Ahnaf-nub/mechaScratch404/chassis/Chassis_Base_2.jpg

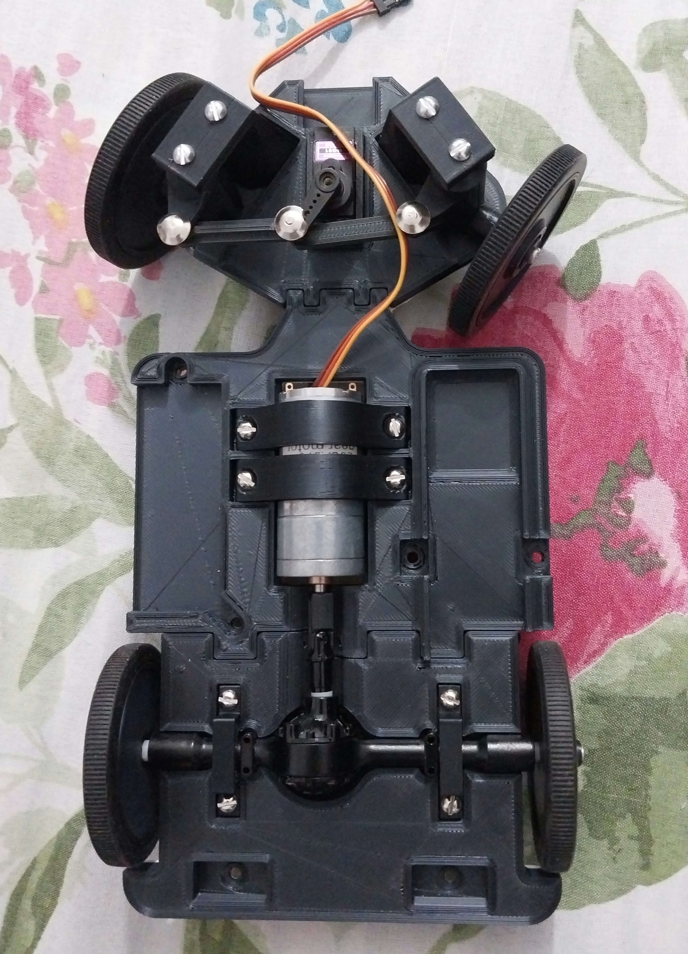
chassis/Chassis_Base_2.jpg
