Ahnaf-nub/mechaScratch404/chassis/Chassis_Base_1.jpg

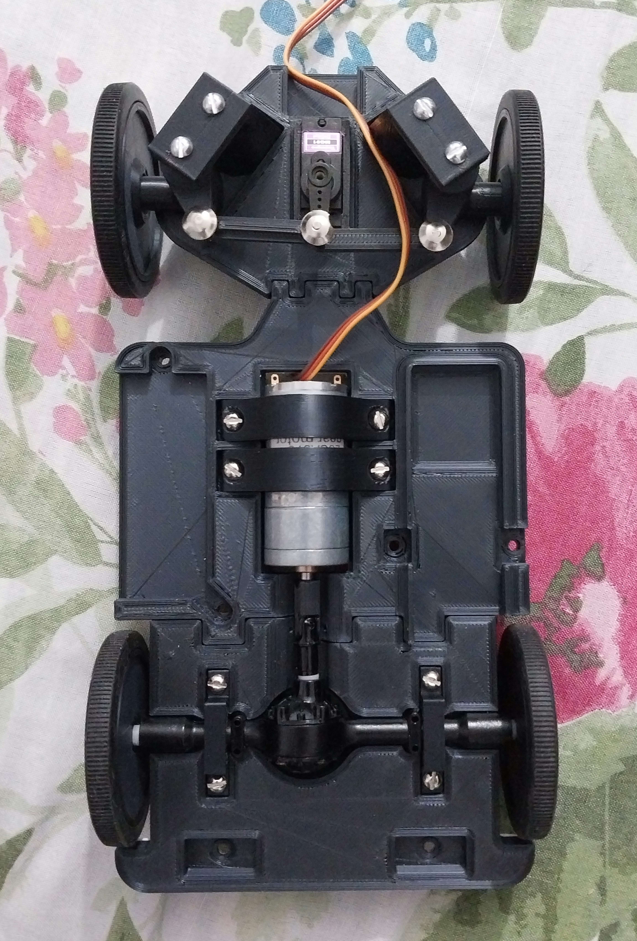
chassis/Chassis_Base_1.jpg
