Ahnaf-nub/mechaScratch404/chassis/README.md

# Overview
This folder contains pictures of the chassis that we used on our robot. This chassis has been designed for 3D printing and is divided into sections, allowing for printing on a relatively smaller print bed.
