Ahnaf-nub/mechaScratch404/schematic/README.md

# Circuit schematics
This folder contains the schematic of the circuit used in the robot.
