Ahnaf-nub/mechaScratch404/schematic/ESP32_Pins_Connections.png

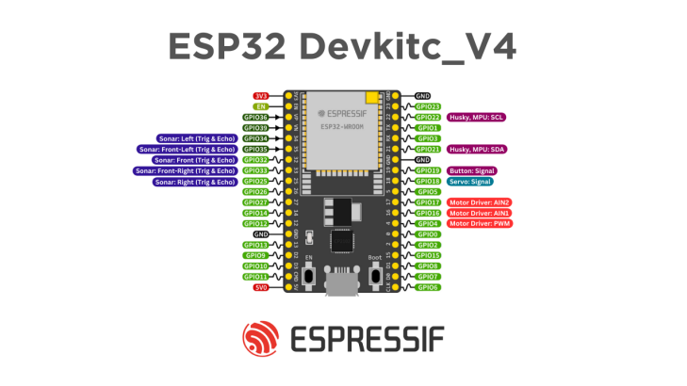
schematic/ESP32_Pins_Connections.png
