Ahnaf-nub/mechaScratch404/schematic/Schematic_esp32_fe_2023-09-10.png

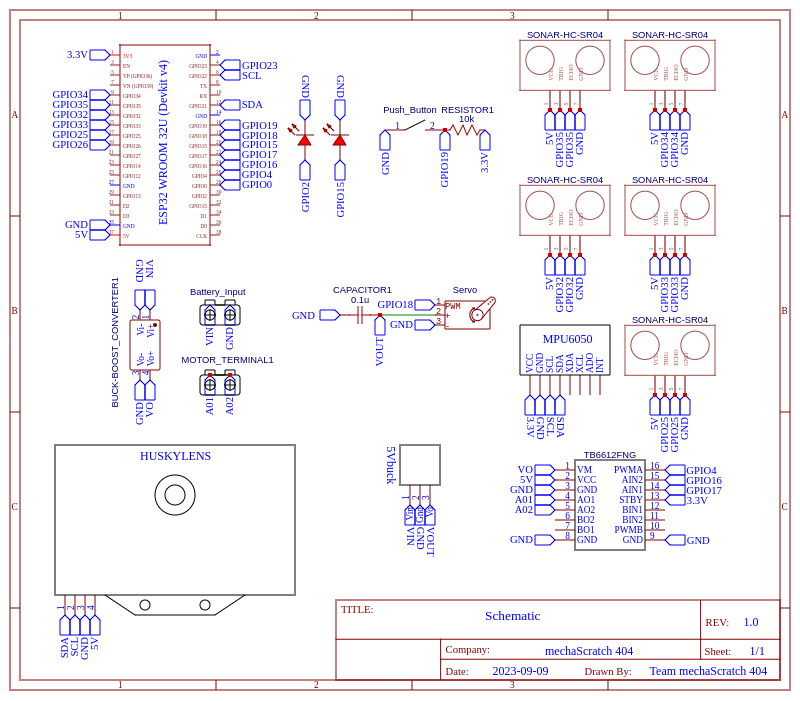
schematic/Schematic_esp32_fe_2023-09-10.png
