Ahnaf-nub/mechaScratch404/v-photos/Back.jpg

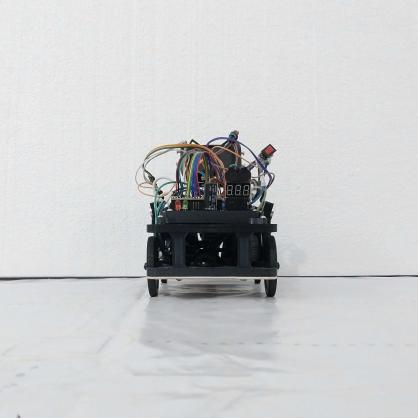
v-photos/Back.jpg
