Ahnaf-nub/mechaScratch404/v-photos/Bottom.jpg

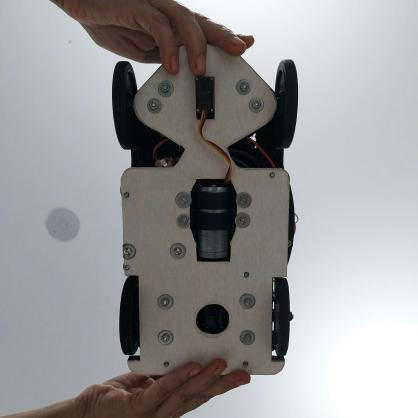
v-photos/Bottom.jpg
