Ahnaf-nub/mechaScratch404/v-photos/Front.jpg

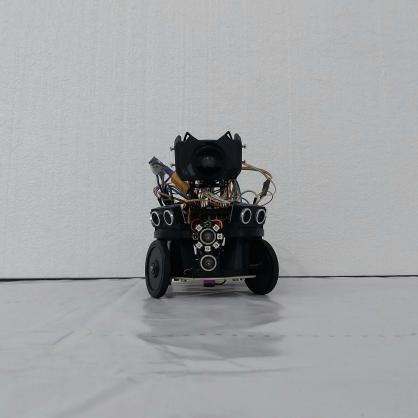
v-photos/Front.jpg
