Ahnaf-nub/mechaScratch404/v-photos/Left.jpg

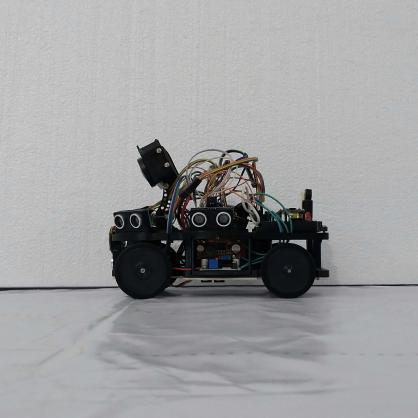
v-photos/Left.jpg
