Ahnaf-nub/mechaScratch404/v-photos/Right.jpg

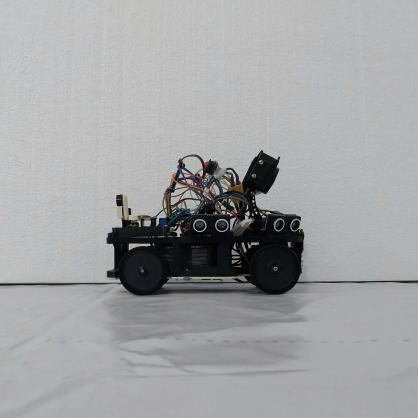
v-photos/Right.jpg
