Ahnaf-nub/mechaScratch404/v-photos/Top.jpg

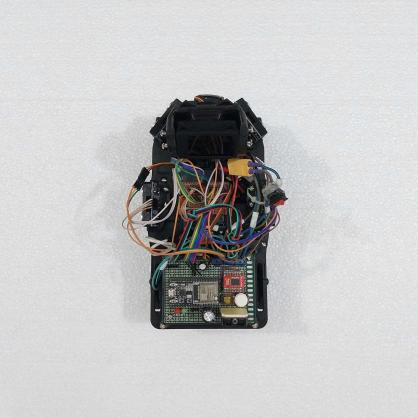
v-photos/Top.jpg
