Ahnaf-nub/mechaScratch404/models/Model_SteerLink (2x).stl

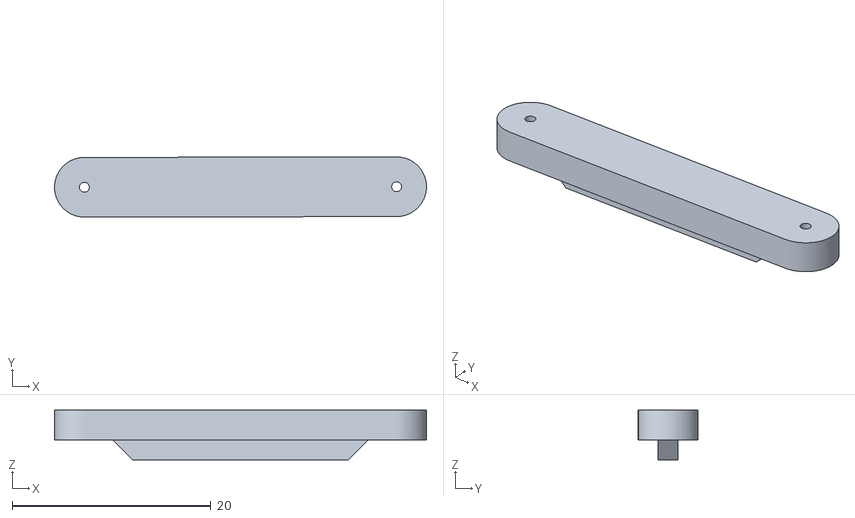
[picture p11: CAD file, 2023-09-09]
models/Model_SteerLink (2x).stl
37.4 x 6.05 x 5.00
