Ahnaf-nub/mechaScratch404/models/Model_Top_Sonar_Mount_Ang_L.stl

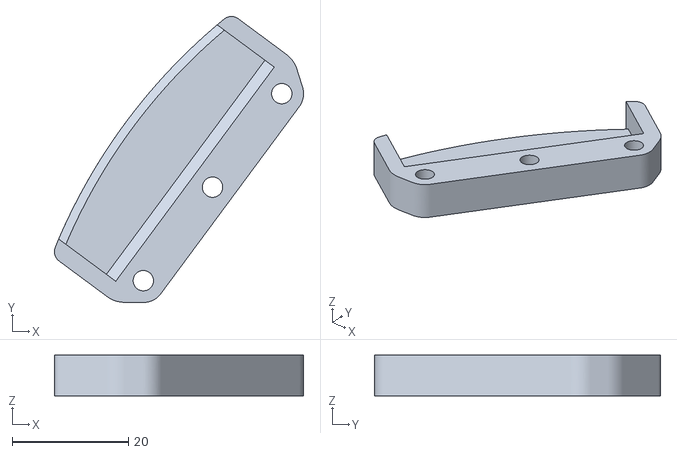
[picture p12: CAD file, 2023-09-09]
models/Model_Top_Sonar_Mount_Ang_L.stl
42.8 x 49.2 x 7.00
