Ahnaf-nub/mechaScratch404/models/Model_Pi_Base.stl

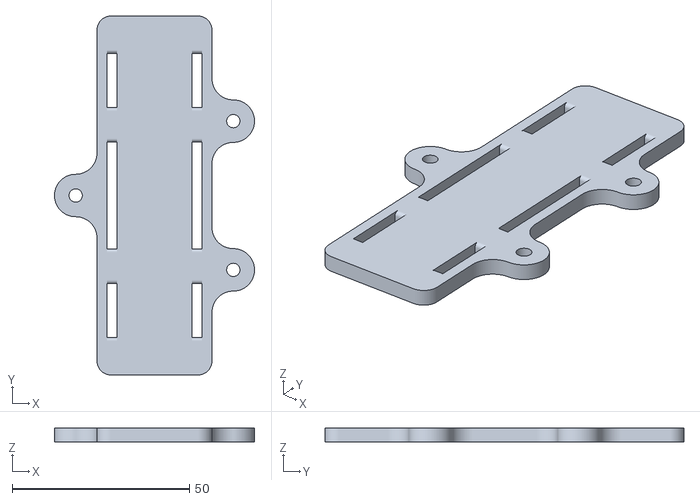
[picture p13: CAD file, 2023-09-09]
models/Model_Pi_Base.stl
56.5 x 101.4 x 4.00
