Ahnaf-nub/mechaScratch404/models/Model_TopPlate_A1.stl

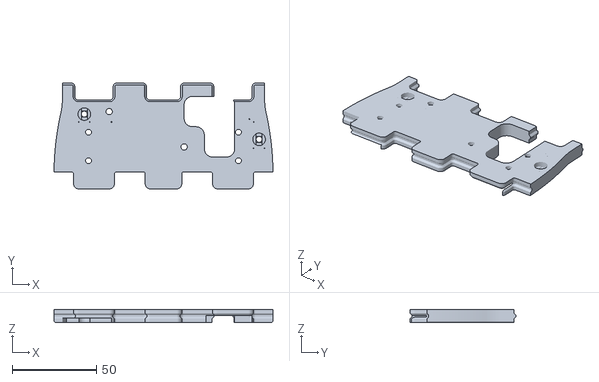
[picture p14: CAD file, 2023-09-09]
models/Model_TopPlate_A1.stl
130.0 x 62.7 x 7.50
