Ahnaf-nub/mechaScratch404/models/Model_TopPlate_B.stl

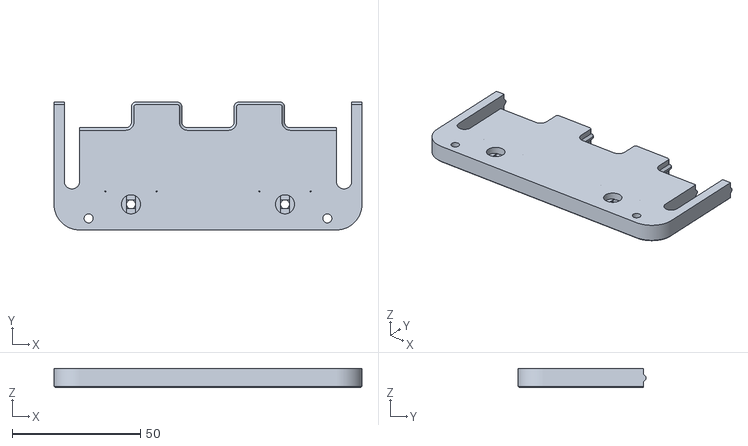
[picture p15: CAD file, 2023-09-09]
models/Model_TopPlate_B.stl
120.0 x 49.8 x 7.50
