Ahnaf-nub/mechaScratch404/models/Model_Pi_Bottom.stl

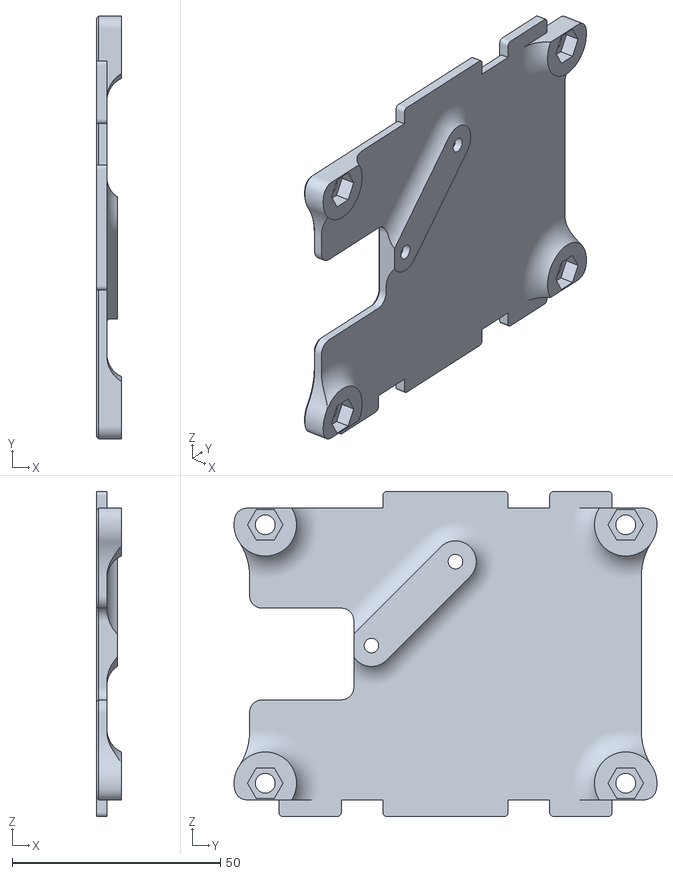
[picture p16: CAD file, 2023-09-09]
models/Model_Pi_Bottom.stl
6.00 x 101.5 x 78.0
