Ahnaf-nub/mechaScratch404/models/Model_Steer_Pin_R.stl

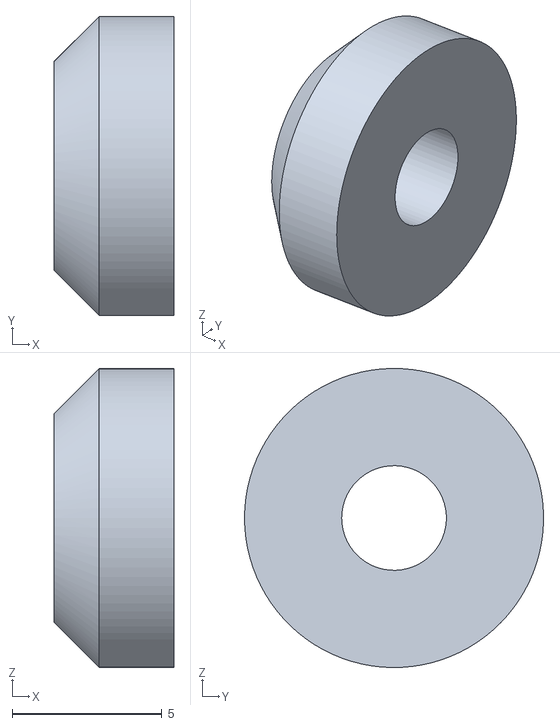
[picture p17: CAD file, 2023-09-09]
models/Model_Steer_Pin_R.stl
4.00 x 10.00 x 10.00
