Ahnaf-nub/mechaScratch404/models/Model_Battery_Clamp.stl

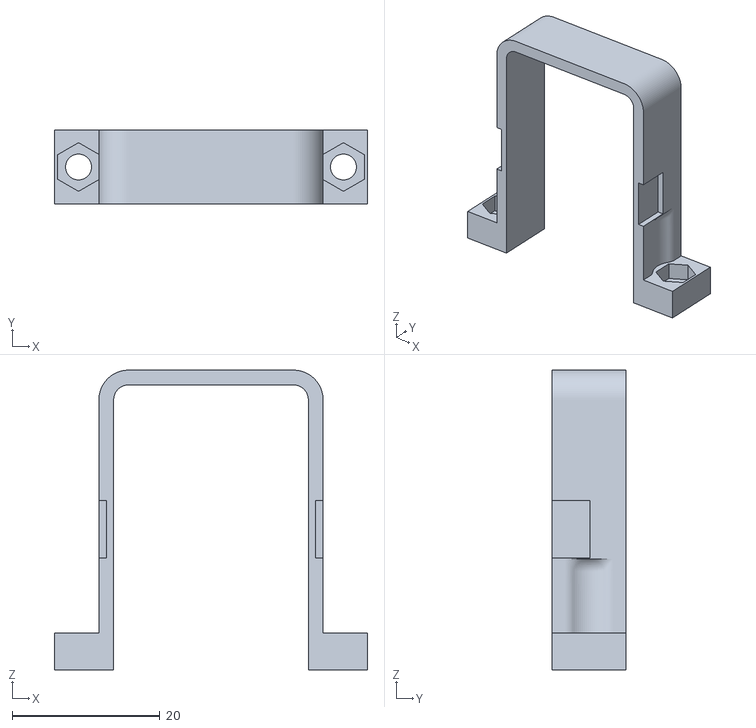
[picture p18: CAD file, 2023-09-09]
models/Model_Battery_Clamp.stl
42.3 x 10.0 x 40.5
