Ahnaf-nub/mechaScratch404/models/Model_Steer_Holder_R.stl

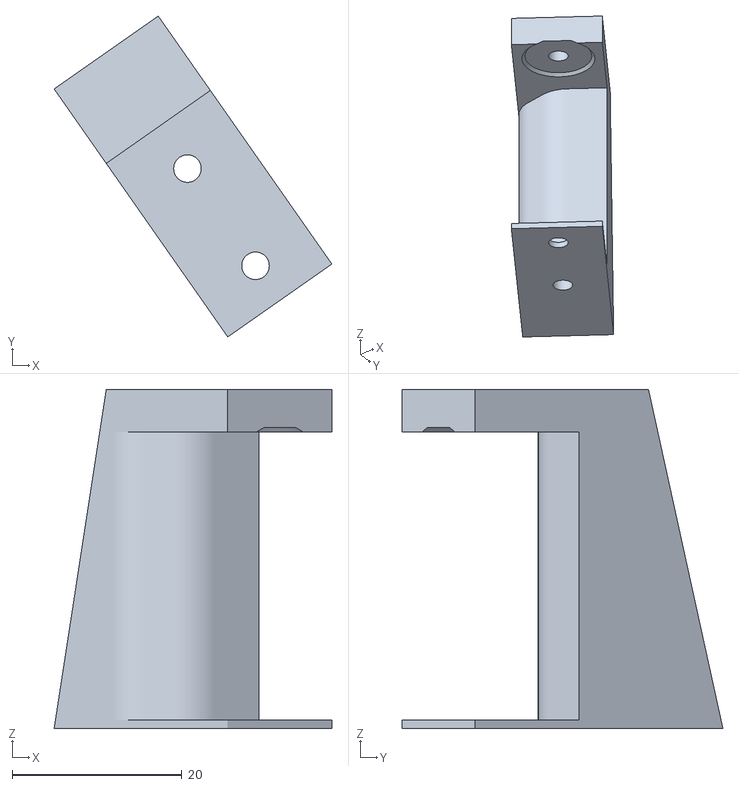
[picture p19: CAD file, 2023-09-09]
models/Model_Steer_Holder_R.stl
32.8 x 37.9 x 40.0
