Ahnaf-nub/mechaScratch404/models/Model_Front_Plate_Base.stl

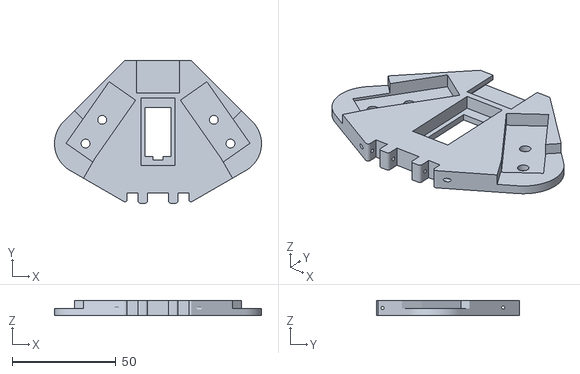
[picture p20: CAD file, 2023-09-09]
models/Model_Front_Plate_Base.stl
100.0 x 68.8 x 7.30
