Ahnaf-nub/mechaScratch404/models/Model_PCB_BreadBoard_Holder.stl

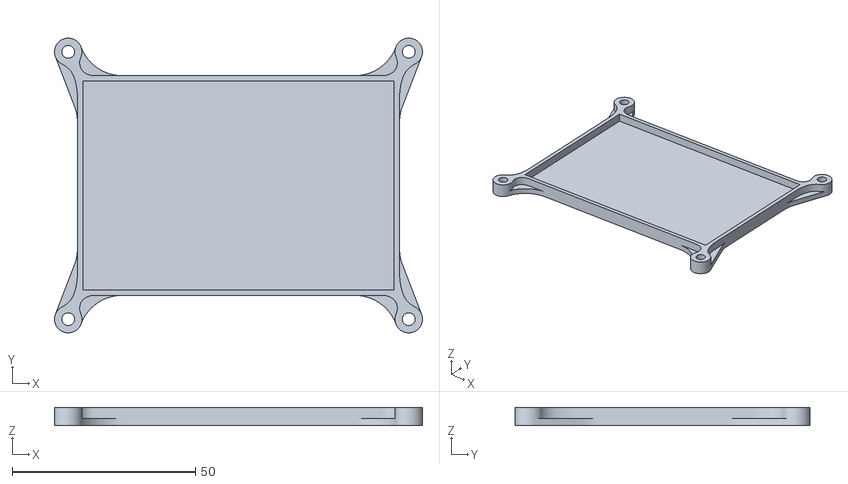
[picture p21: CAD file, 2023-09-09]
models/Model_PCB_BreadBoard_Holder.stl
100.5 x 80.5 x 5.00
