Ahnaf-nub/mechaScratch404/models/Model_Base_Rear.stl

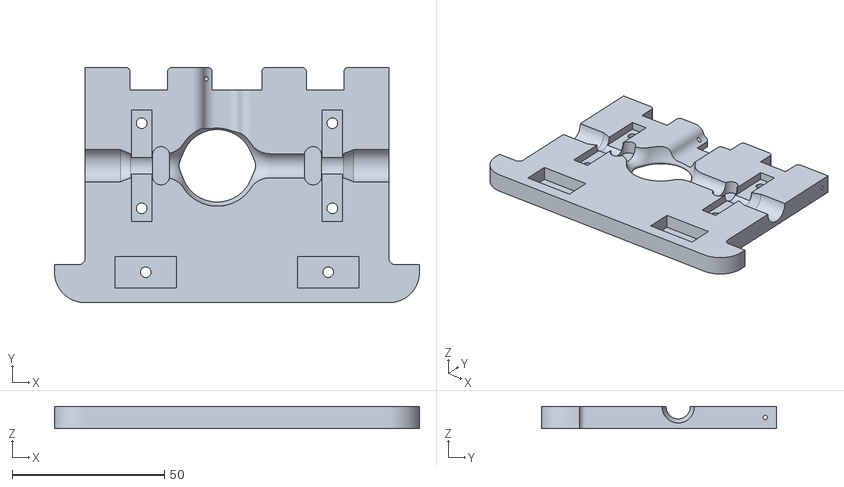
[picture p22: CAD file, 2023-09-09]
models/Model_Base_Rear.stl
120.0 x 77.3 x 7.30
