Ahnaf-nub/mechaScratch404/models/Model_Pi_Top.stl

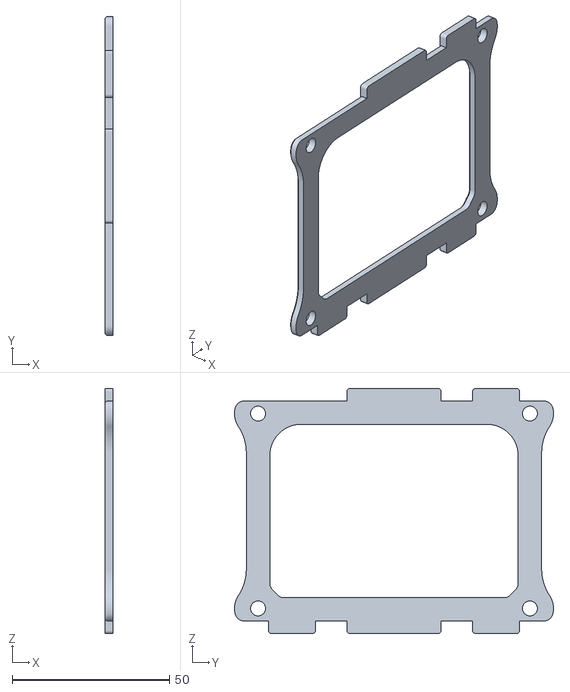
[picture p23: CAD file, 2023-09-09]
models/Model_Pi_Top.stl
2.50 x 101.5 x 78.0
