Ahnaf-nub/mechaScratch404/models/Model_Pi_PowerModuleHolder.stl

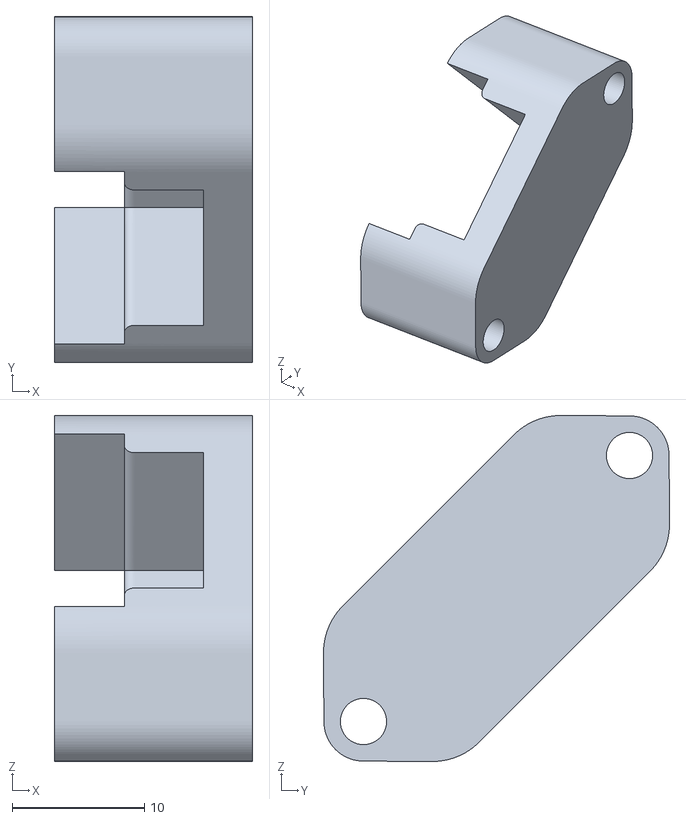
[picture p25: CAD file, 2023-09-09]
models/Model_Pi_PowerModuleHolder.stl
15.0 x 26.2 x 26.2
