Ahnaf-nub/mechaScratch404/models/Model_Pi_Roof.stl

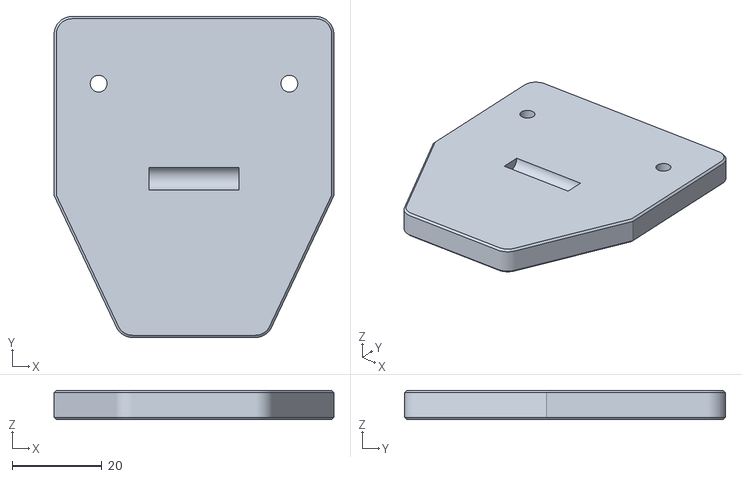
[picture p26: CAD file, 2023-09-09]
models/Model_Pi_Roof.stl
62.5 x 71.7 x 6.50
