Ahnaf-nub/mechaScratch404/models/Model_Buck-Boost_Holder.stl

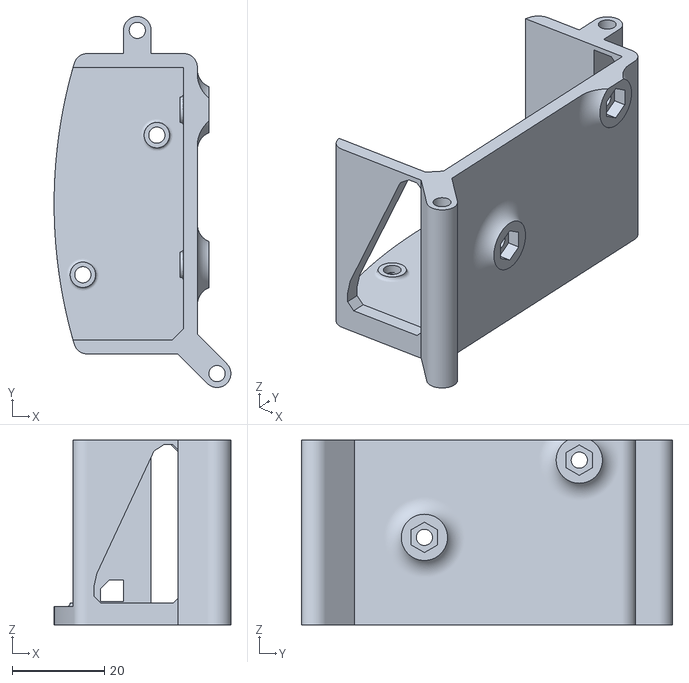
[picture p27: CAD file, 2023-09-09]
models/Model_Buck-Boost_Holder.stl
38.2 x 80.2 x 40.0
