Ahnaf-nub/mechaScratch404/models/Model_Rear_Support (2x).stl

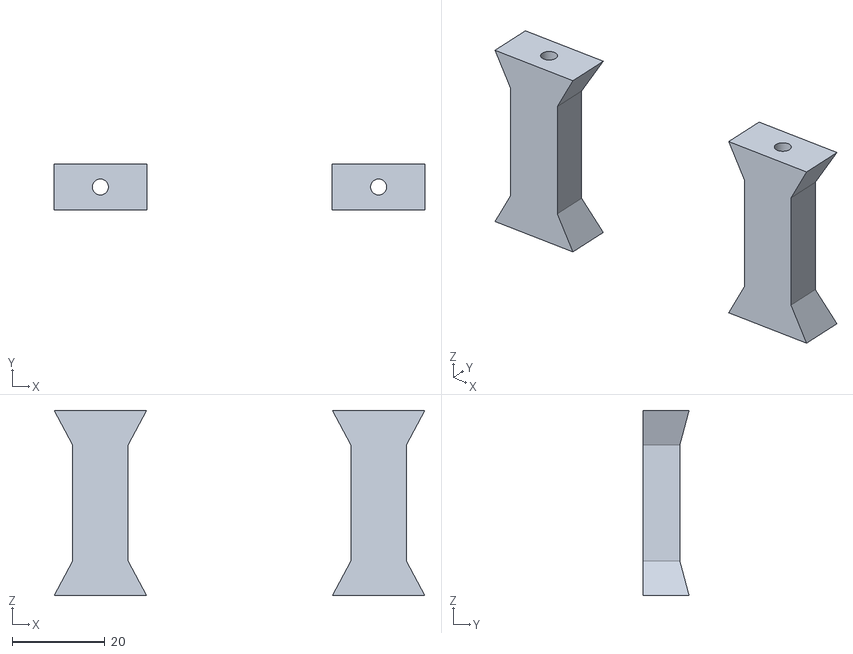
[picture p28: CAD file, 2023-09-09]
models/Model_Rear_Support (2x).stl
80.0 x 10.0 x 40.0
