Ahnaf-nub/mechaScratch404/models/Model_Steer_L.stl

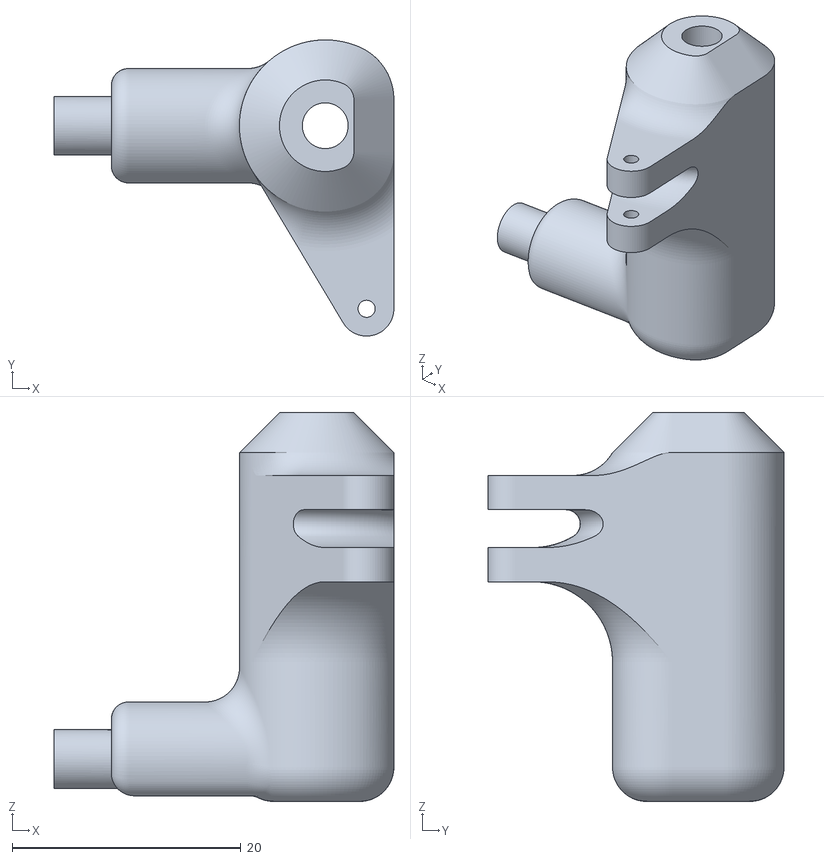
[picture p29: CAD file, 2023-09-09]
models/Model_Steer_L.stl
29.7 x 25.9 x 34.0
