Ahnaf-nub/mechaScratch404/models/Model_ServoHolder.stl

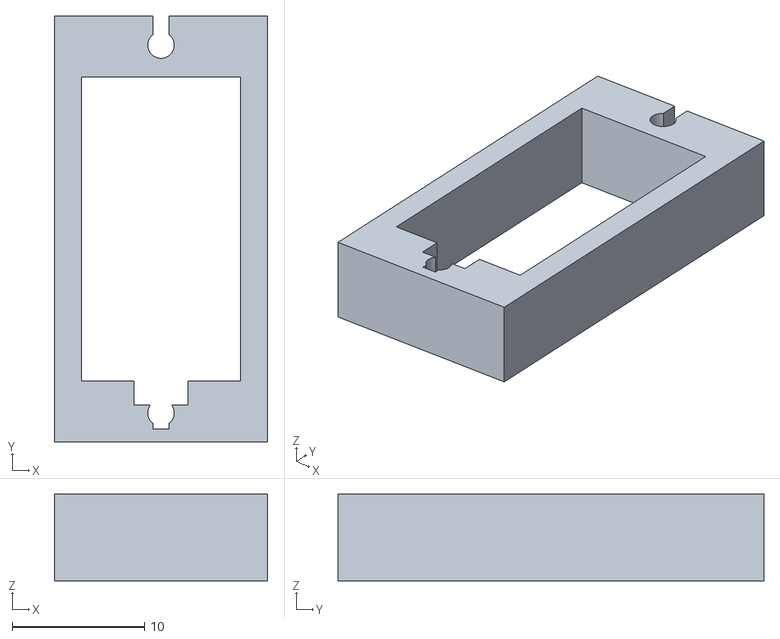
[picture p30: CAD file, 2023-09-09]
models/Model_ServoHolder.stl
16.1 x 32.2 x 6.57
