Ahnaf-nub/mechaScratch404/models/Model_Mid_Support_B.stl

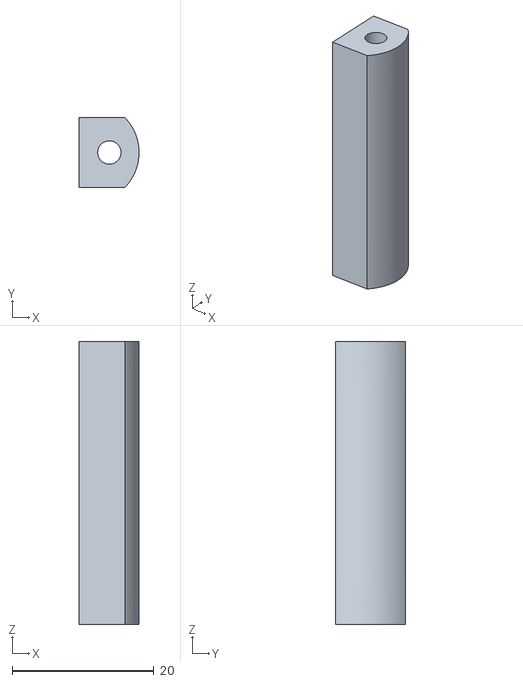
[picture p31: CAD file, 2023-09-09]
models/Model_Mid_Support_B.stl
8.50 x 9.85 x 40.0
