Ahnaf-nub/mechaScratch404/models/Model_Mid_Support_A.stl

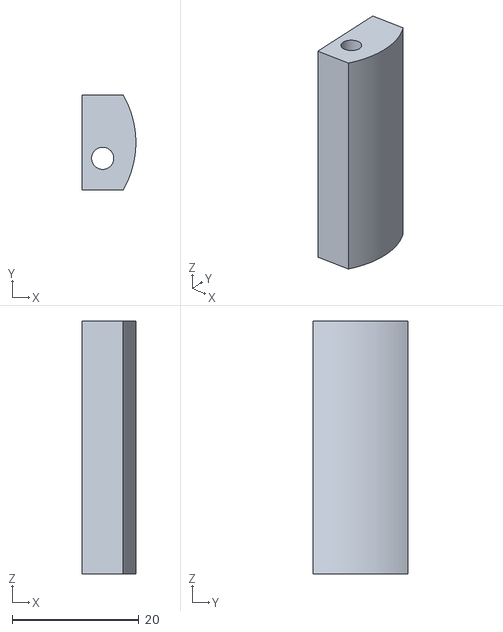
[picture p32: CAD file, 2023-09-09]
models/Model_Mid_Support_A.stl
8.50 x 15.0 x 40.0
