Ahnaf-nub/mechaScratch404/models/Model_TopPlate_A.stl

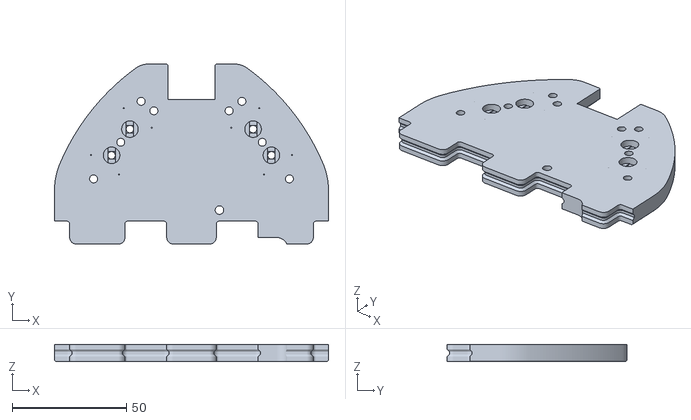
[picture p33: CAD file, 2023-09-09]
models/Model_TopPlate_A.stl
120.0 x 78.8 x 7.50
