Ahnaf-nub/mechaScratch404/models/Model_Middle_Plate_Base.stl

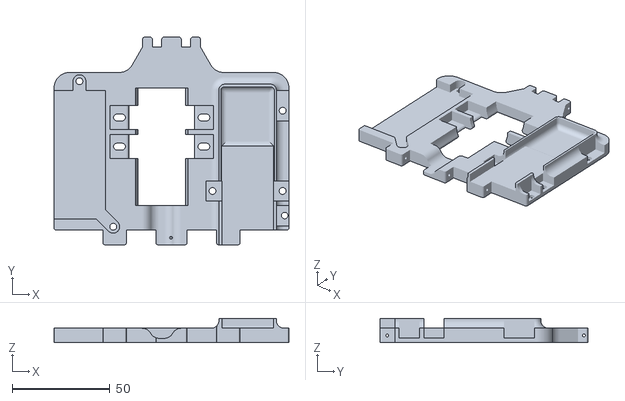
[picture p34: CAD file, 2023-09-09]
models/Model_Middle_Plate_Base.stl
120.0 x 106.0 x 12.3
