Ahnaf-nub/mechaScratch404/models/Model_Pin_Axle (2x).stl

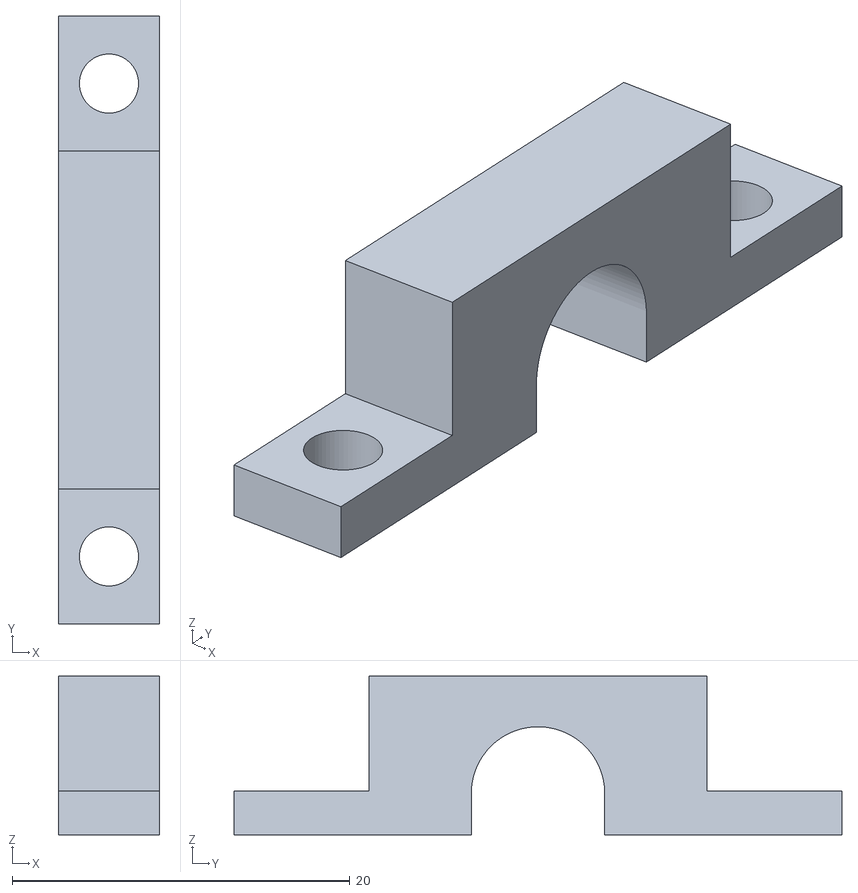
[picture p35: CAD file, 2023-09-09]
models/Model_Pin_Axle (2x).stl
6.00 x 36.0 x 9.40
