Ahnaf-nub/mechaScratch404/models/Model_Top_Sonar_Mount_R.stl

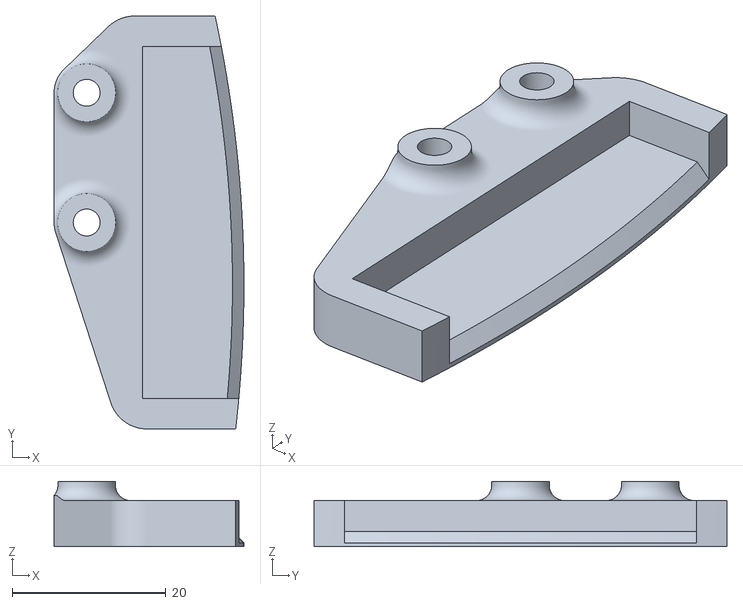
[picture p36: CAD file, 2023-09-09]
models/Model_Top_Sonar_Mount_R.stl
24.7 x 53.8 x 8.50
