Ahnaf-nub/mechaScratch404/models/Model_SonarHolder_F.stl

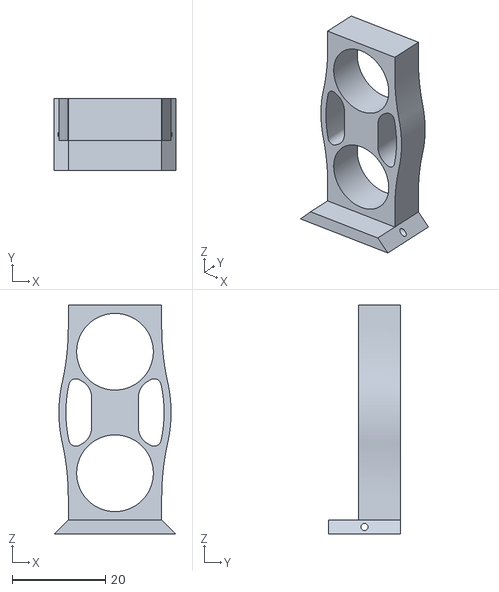
[picture p37: CAD file, 2023-09-09]
models/Model_SonarHolder_F.stl
26.0 x 15.5 x 49.0
