Ahnaf-nub/mechaScratch404/models/Model_Cam_Top_Clamp.stl

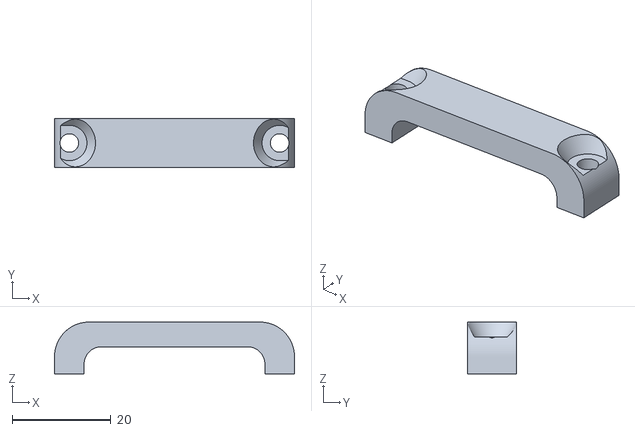
[picture p38: CAD file, 2023-09-09]
models/Model_Cam_Top_Clamp.stl
48.6 x 10.0 x 10.5
