Ahnaf-nub/mechaScratch404/models/Model_Top_Sonar_Holder (4x).stl

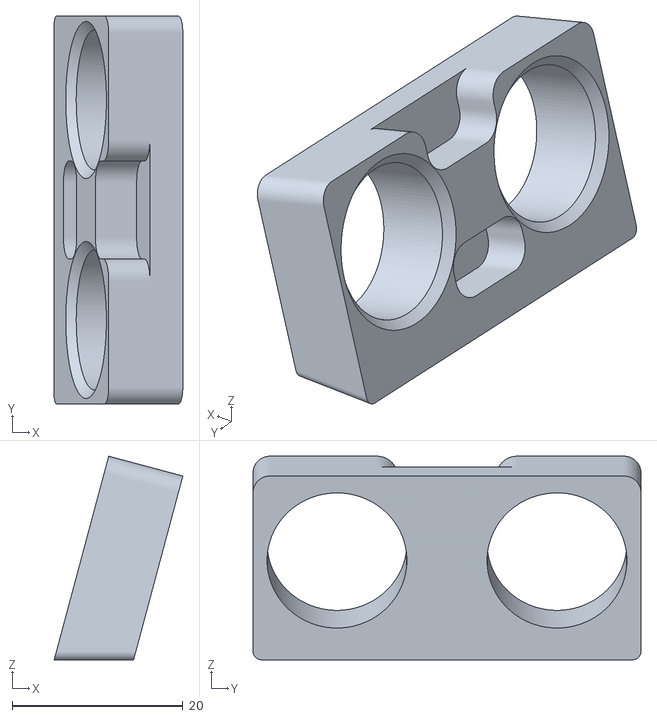
[picture p39: CAD file, 2023-09-09]
models/Model_Top_Sonar_Holder (4x).stl
15.1 x 45.5 x 23.9
