Ahnaf-nub/mechaScratch404/models/Model_TopPlate_B1.stl

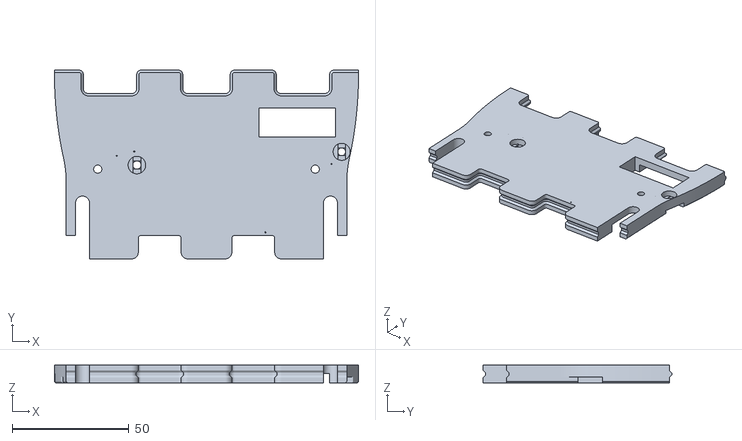
[picture p40: CAD file, 2023-09-09]
models/Model_TopPlate_B1.stl
130.0 x 80.7 x 7.50
