Ahnaf-nub/mechaScratch404/models/Model_Motor_Holder_Top (2x).stl

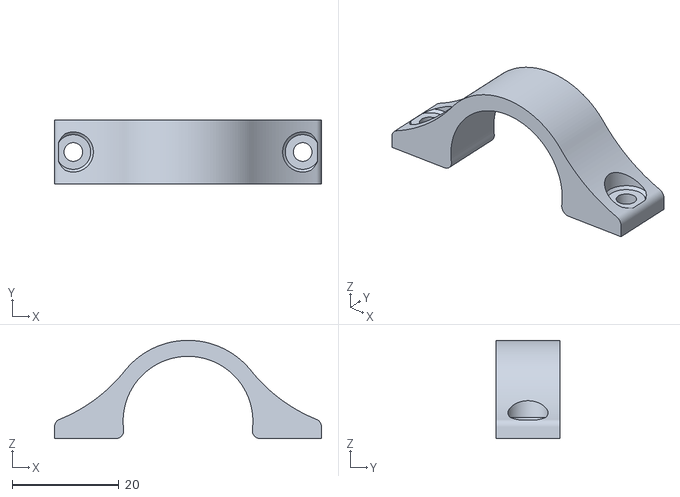
[picture p41: CAD file, 2023-09-09]
models/Model_Motor_Holder_Top (2x).stl
50.0 x 12.0 x 18.4
