Ahnaf-nub/mechaScratch404/(list of files, cad)

Other CAD files:
models/Model_Top_Sonar_Mount_Ang_R.stl
models/Model_Steer_Holder_L.stl
models/Model_Steer_R.stl
models/Model_Top_Sonar_Mount_L.stl
models/Model_Steer_Pin_L.stl
