Ahnaf-nub/mechaScratch404/(commit log)

2023-09-22 README.md for schematics
2023-09-23 Update and rename experiments/Sonar5x.ino to experiments/Sonar5x/Sonar5x.ino
